geus-clan/TFRAS/README.md

# TFRAS
PCB prototype for sensor board used with resistive automatic ablation sensor.
