geus-clan/TFRAS/TFRAS/TFRAS_BOM.csv

Id | Designator | Package | Quantity | Designation | Supplier and ref
1 | J1,J2 | Molex_SlimStack_54722-0804_2x40_P0.50mm_Vertical | 2 |  | https://www.molex.com/molex/products/part-detail/pcb_receptacles/0547220804
