geus-clan/TFRAS/Software/TFRAS_calibrated_2.txt

/*
 * to do:
 * 
 * boards all return raw ADC
 * top boards compares against calibration table
 * this way the whole string can be calibrated once
 * 
 */

#define ADDRESS 99

/*
 * 97   a
 * 98   b
 * 99   c
 * 100  d
 * 101 e
 * 102 f
 * 
 */

#define UART_TX 44
#define UART_RX 45
#define TX_EN 2

#define S0 33
#define S1 32
#define S2 31

#define S0_ 16
#define S1_ 15
#define S2_ 14

//analog returns from mux
#define A_TOP 36
#define A_BOTTOM 25

#define ADC_THERM 29

#define nominal_resistance 10000       //Nominal resistance at 25⁰C
#define nominal_temeprature 25   // temperature for nominal resistance (almost always 25⁰ C)
#define samplingrate 5    // Number of samples 
#define beta 3950  // The beta coefficient or the B value of the thermistor (usually 3000-4000) check the datasheet for the accurate value.
#define Rref 10000   //Value of  resistor used for the voltage divider
int samples = 0;   //array to store the samples

//digital power pins
//top:
#define A 3
#define C 39
#define E 38
#define G 37
#define I 4
#define K 5
#define M 6

//bottom:
#define B_ 17
#define D_ 12
#define F_ 11
#define H_ 26
#define J_ 27
#define L_ 28

//analog pin addresses:
//top:
#define B 0
#define H 1
#define J 2
#define D 3
#define L 4
#define F 5

//bottom:
#define I_ 0
#define K_ 1
#define M_ 2
#define A_ 3
#define C_ 4
#define G_ 5
#define E_ 7

int topFlex[12];     //arrays for storing the cm of readings. e.g. topFlex[6] is between 6 and 7cm
int bottomFlex[12];

int topFlat[12] = {434,443,462,432,429,464,433,456,389,501,546,157};    //arrays for calibration at flat orientation
int bottomFlat[12] = {679,359,507,230,619,444,439,381,470,440,406,283};

int bottomBent[12]; //arrays for storing how bent the positions are in relation to flat orientation
int topBent[12];

/*
                    
A:
int topFlat[12] = {}; //calibration points --- what the standard ADC measurements are when they're flat. this should be optimized a lot later. temporary.
int bottomFlat[12] = {463, 466, 335, 333, 523, 413, 468, 470, 399, 341, 530, 251,};

B:int topFlat[12] = {434,443,462,432,429,464,433,456,389,501,546,157};    //arrays for calibration at flat orientation
int bottomFlat[12] = {679,359,507,230,619,444,439,381,470,440,406,283};
C:
int topFlat[12] = {299,500,414,433,456,374,432,362,326,458,312,259};    //arrays for calibration at flat orientation
int bottomFlat[12] = {664,407,444,418,436,462,392,375,415,416,409,358};
D:
int topFlat[12] = {403, 472, 440, 441, 362, 475, 366, 519, 446, 457, 501, 195};
int bottomFlat[12] = {594, 331, 496, 513, 308, 425, 401, 357, 404, 369, 427, 362};
                  
*/

void setCalibration(int adr){
  switch(adr){
    case 97: //'a'
     int a[24] = {0,0,0,0,0,0,0,0,0,0,0,0,578,378,450,342,529,444,453,507,377,384,498,260};
     for (int i=0;i<12;i++){
      topFlat[i] = a[i];
     }
     for (int i=12;i<24;i++){
      bottomFlat[i] = a[i];
     }

    break;
    case 98: //'b'
     int b[24] = {5,-37,-44,8,1,-20,-23,0,-32,16,-4,-9,76,-10,-50,-43,-30,-74,31,55,-17,-19,62,92};
     for (int i=0;i<12;i++){
      topFlat[i] = b[i];
     }
     for (int i=12;i<24;i++){
      bottomFlat[i] = b[i];
     }
    
    break;
    case 99: //'c'
     int c[24] = {299,500,414,433,456,374,432,362,326,458,312,259,664,407,444,418,436,462,392,375,415,416,409,358};
     for (int i=0;i<12;i++){
      topFlat[i] = c[i];
     }
     for (int i=12;i<24;i++){
      bottomFlat[i] = c[i];
     }
    break;
    
    case 100: //'d'
     int d[24] = {299,500,414,433,456,374,432,362,326,458,312,259,664,407,444,418,436,462,392,375,415,416,409,358};
     for (int i=0;i<12;i++){
      topFlat[i] = d[i];
     }
     for (int i=12;i<24;i++){
      bottomFlat[i] = d[i];
     }
    break;
  
  }
}

void setup() {

  //setCalibration(99);

Serial.begin(9600);

    pinMode(A_TOP, INPUT);
    pinMode(A_BOTTOM, INPUT);
    pinMode(ADC_THERM, INPUT);

    pinMode(A, OUTPUT);
    pinMode(C, OUTPUT);
    pinMode(E, OUTPUT);
    pinMode(G, OUTPUT);
    pinMode(I, OUTPUT);
    pinMode(K, OUTPUT); 
    pinMode(M, OUTPUT); 

    pinMode(B_, OUTPUT);
    pinMode(D_, OUTPUT);
    pinMode(F_, OUTPUT);
    pinMode(H_, OUTPUT);
    pinMode(J_, OUTPUT);
    pinMode(L_, OUTPUT); 

  pinMode(TX_EN, OUTPUT);

  pinMode(S0, OUTPUT);
  pinMode(S1, OUTPUT);
  pinMode(S2, OUTPUT);

  pinMode(S0_, OUTPUT);
  pinMode(S1_, OUTPUT);
  pinMode(S2_, OUTPUT);
  
  //digitalWrite(TX_EN, HIGH); //just temporary for testing: allow serial transmission any time
  
   digitalWrite(TX_EN, LOW); 

}

void readFlex(){
  /////Top section
  digitalWrite(A,HIGH);
  topFlex[11] = flexT(B) / 2.0; //TEMPORARY WORKAROUND
  digitalWrite(A,LOW);

  digitalWrite(C,HIGH);
  topFlex[10] = flexT(B);
  topFlex[9] = flexT(D);
  digitalWrite(C,LOW);

  digitalWrite(E,HIGH);
  topFlex[8] = flexT(D);
  topFlex[7] = flexT(F);
  digitalWrite(E,LOW);

  digitalWrite(G,HIGH);
  topFlex[6] = flexT(F);
  topFlex[5] = flexT(H);
  digitalWrite(G,LOW);
  
  digitalWrite(I,HIGH);
  topFlex[4] = flexT(H);
  topFlex[3] = flexT(J);
  digitalWrite(I,LOW);

  digitalWrite(K,HIGH);
  topFlex[2] = flexT(J);
  topFlex[1] = flexT(L);
  digitalWrite(K,LOW);

  digitalWrite(M,HIGH);
  topFlex[0] = flexT(L);
  digitalWrite(M,LOW);

  /////Bottom section
  digitalWrite(B_,HIGH);
  bottomFlex[0] = flexB(A_);
  bottomFlex[1] = flexB(C_);
  digitalWrite(B_,LOW);

  digitalWrite(D_,HIGH);
  bottomFlex[2] = flexB(C_);
  bottomFlex[3] = flexB(E_);
  digitalWrite(D_,LOW);

  digitalWrite(F_,HIGH);
  bottomFlex[4] = flexB(E_);
  bottomFlex[5] = flexB(G_);
  digitalWrite(F_,LOW);

  digitalWrite(H_,HIGH);
  bottomFlex[6] = flexB(G_);
  bottomFlex[7] = flexB(I_);
  digitalWrite(H_,LOW);
  
  digitalWrite(J_,HIGH);
  bottomFlex[8] = flexB(I_);
  bottomFlex[9] = flexB(K_);
  digitalWrite(J_,LOW);

  digitalWrite(L_,HIGH);
  bottomFlex[10] = flexB(K_);
  bottomFlex[11] = flexB(M_) / 2.0; //TEMPORARY WORKAROUND - last measurement 
  digitalWrite(L_,LOW);

}

int flexB(int a){
  addressMux(a);
  return analogRead(A_BOTTOM);
}

int flexT(int a){
  addressMux(a);
  return analogRead(A_TOP);
}

void addressMux(int a){
  switch(a){
    case 0:
    digitalWrite(S0,LOW);
    digitalWrite(S1,LOW);
    digitalWrite(S2,LOW);

    digitalWrite(S0_,LOW);
    digitalWrite(S1_,LOW);
    digitalWrite(S2_,LOW);
    break;
        
    case 1:
    digitalWrite(S0,HIGH);
    digitalWrite(S1,LOW);
    digitalWrite(S2,LOW);

    digitalWrite(S0_,HIGH);
    digitalWrite(S1_,LOW);
    digitalWrite(S2_,LOW);
    break;
        case 2:
    digitalWrite(S0,LOW);
    digitalWrite(S1,HIGH);
    digitalWrite(S2,LOW);

    digitalWrite(S0_,LOW);
    digitalWrite(S1_,HIGH);
    digitalWrite(S2_,LOW);
    break;
    
    case 3:
    digitalWrite(S0,HIGH);
    digitalWrite(S1,HIGH);
    digitalWrite(S2,LOW);

    digitalWrite(S0_,HIGH);
    digitalWrite(S1_,HIGH);
    digitalWrite(S2_,LOW);
    break;
        
    case 4:
    digitalWrite(S0,LOW);
    digitalWrite(S1,LOW);
    digitalWrite(S2,HIGH);

    digitalWrite(S0_,LOW);
    digitalWrite(S1_,LOW);
    digitalWrite(S2_,HIGH);
    break;
    
        case 5:        
    digitalWrite(S0,HIGH);
    digitalWrite(S1,LOW);
    digitalWrite(S2,HIGH);

    digitalWrite(S0_,HIGH);
    digitalWrite(S1_,LOW);
    digitalWrite(S2_,HIGH);
    break;
            case 7:
    digitalWrite(S0,HIGH);
    digitalWrite(S1,HIGH);
    digitalWrite(S2,HIGH);

    digitalWrite(S0_,HIGH);
    digitalWrite(S1_,HIGH);
    digitalWrite(S2_,HIGH);
    break;
  }
}

void printResults(){
    
 for(int i=0;i<12;i++){
    Serial.print(topFlex[i]);
    Serial.print(", ");
  }
  
 for(int i=0;i<12;i++){
    Serial.print(bottomFlex[i]);
    Serial.print(", ");
  }
    
  Serial.println();

}

int checkBend(int i){
  int x; //local result
  
    if(i < 200){
      x = 1;  //register binary bend in one direction
    }
    else if(i < 300){
      x = 2;  //register binary bend in one direction
    }
    else if(i > 500){
      x = 4;  //other direction
    }
    else if(i > 600){
      x = 5;  //other direction
    }
    else {
      x=3;  //no bend
    
 }
 return x;
    
}

int compareFlat(int i){
  int x; //local result
  /*
    if(topFlat[i] < topFlex){
      x = 1;  //register binary bend in one direction
    }
    else if(i < 300){
      x = 2;  //register binary bend in one direction
 }
 */
 x = topFlat[i] - topFlex[i];
 return x;
    
}

void loop() {

if (Serial.available() > 0){

 while (Serial.available() > 0)
 {
    int c = Serial.read();
    
    if (c == ADDRESS){
    
     readFlex();

      digitalWrite(TX_EN, HIGH);
      delay(15);
        Serial.print("<,");
    for(int i=0;i<12;i++){
      //Serial.print(topFlat[i] - topFlex[i]);
      Serial.print(topFlex[i]);

      Serial.print(",");
    }

    for(int i=0;i<12;i++){
      //Serial.print(bottomFlat[i] - bottomFlex[i]);
      
      Serial.print(bottomFlex[i]);

      Serial.print(",");
    }
    
     Serial.print((int)readTemp());
     Serial.println('>');
     Serial.flush();  //wait for all data to be sent before disabling coms
     digitalWrite(TX_EN, LOW);//rx enable, tx disable

   }

 }
  
}

}

float readTemp(void) {
  uint8_t i;
  float average;
  samples = 0;
  
  // take voltage readings from the voltage divider
  for (i = 0; i < samplingrate; i++) {
    samples += analogRead(ADC_THERM);
    delay(10);
  }
  average = 0;
  average = samples / samplingrate;

  // Calculate NTC resistance
  average = 1023 / average - 1;
  average = Rref / average;

  float temperature;
  temperature = average / nominal_resistance;     // (R/Ro)
  temperature = log(temperature);                  // ln(R/Ro)
  temperature /= beta;                   // 1/B * ln(R/Ro)
  temperature += 1.0 / (nominal_temeprature + 273.15); // + (1/To)
  temperature = 1.0 / temperature;                 // Invert
  temperature -= 273.15;                         // convert absolute temp to C

  return temperature*100.0; //must divide by 100 to get correct value. using ints because all bend data is int

}
