geus-clan/TFRAS/Schematics and PCBs/TFRAS_TOP/Gerbers, TFRAS_TOP/Testing plan.pdf

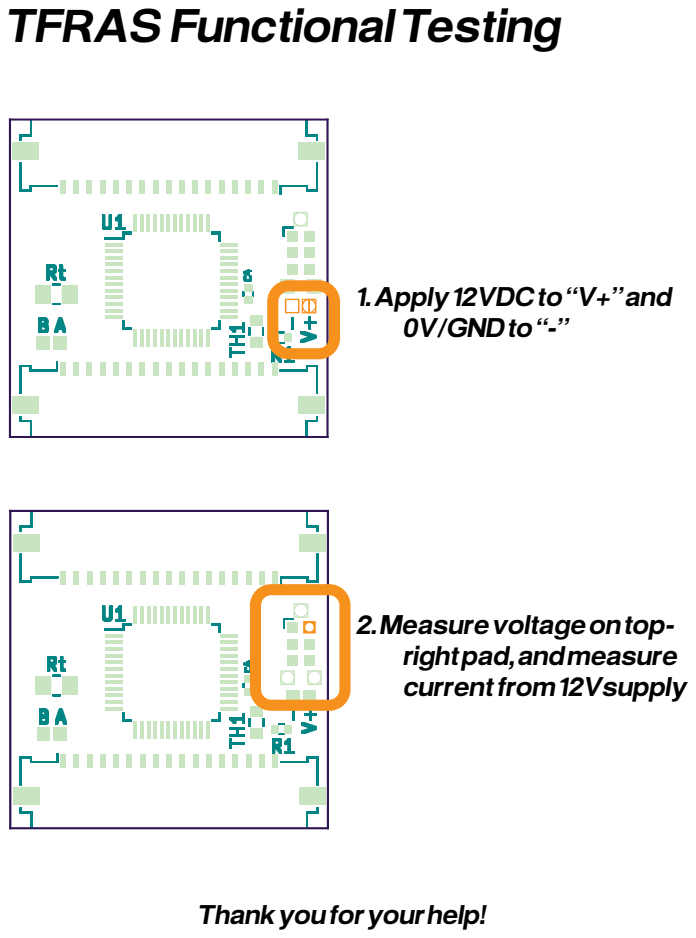
[picture p1: page 1]

2. Measure voltage on top-
right pad, and measure
current from 12Vsupply

Thank you for your help!
