geus-clan/TFRAS/Schematics and PCBs/PDFs/PCB_back.pdf

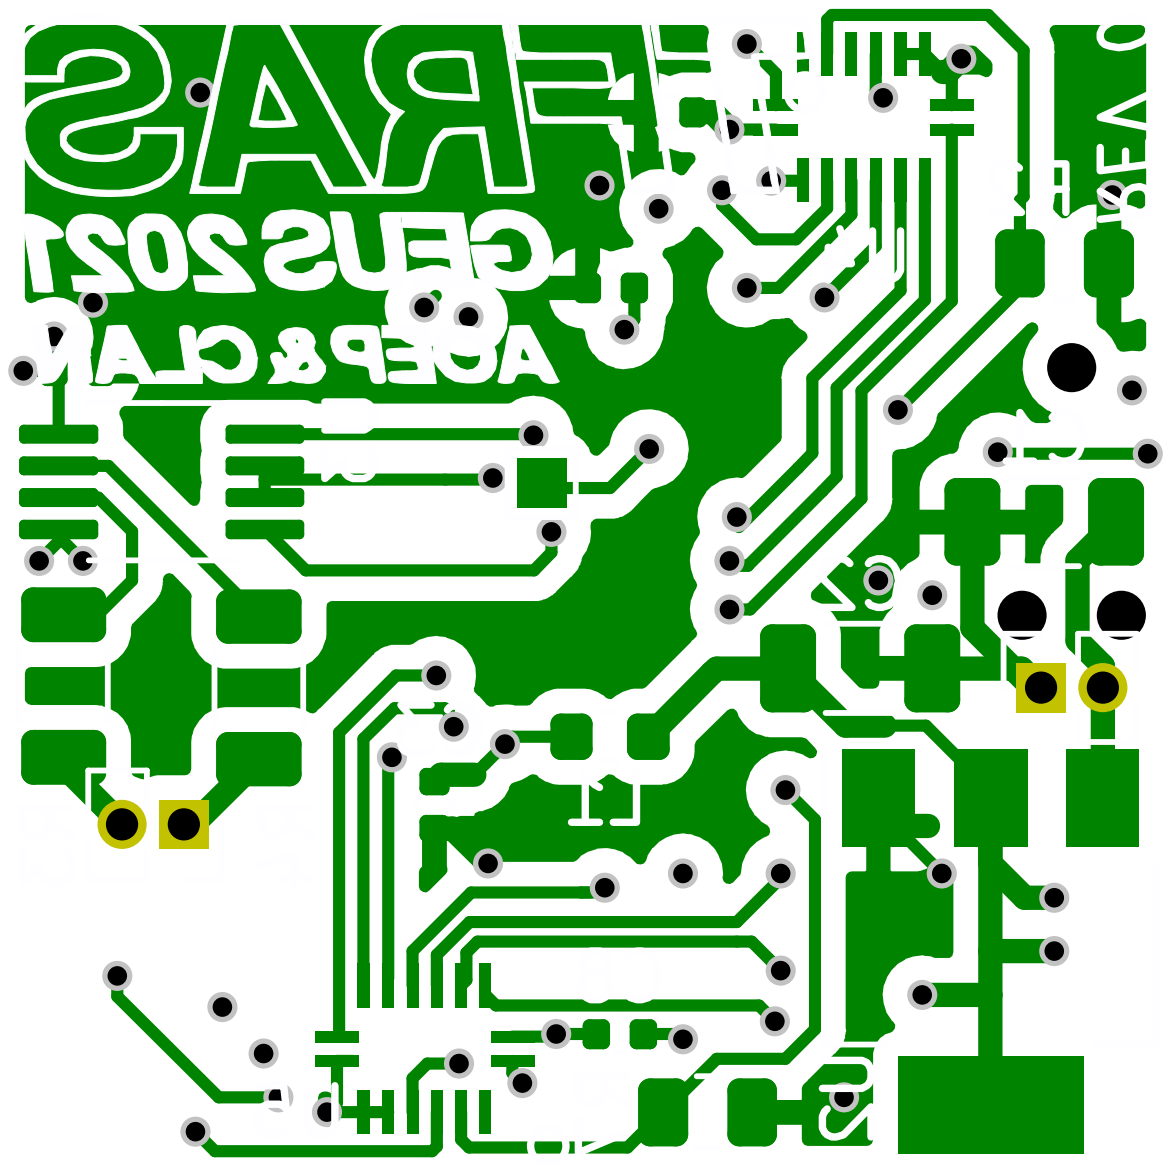
[picture p2: page 1]
