geus-clan/TFRAS/Schematics and PCBs/PDFs/PCB_front.pdf

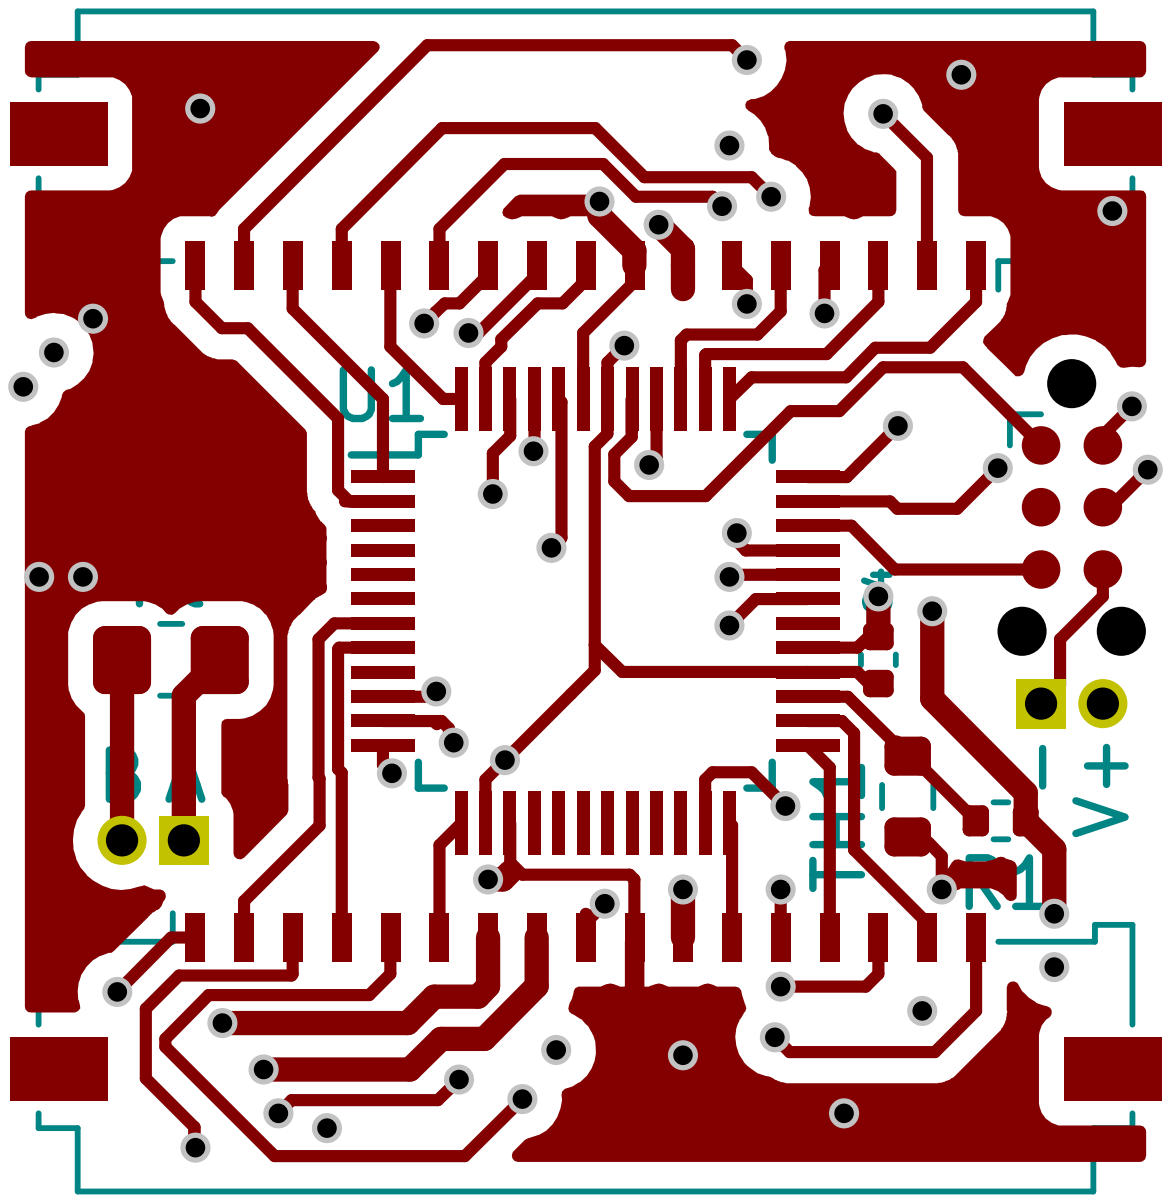
[picture p3: page 1]
