geus-clan/TFRAS/Schematics and PCBs/TFRAS_TOP/Gerbers, TFRAS_TOP/TFRAS_TOP-B_Cu.pdf

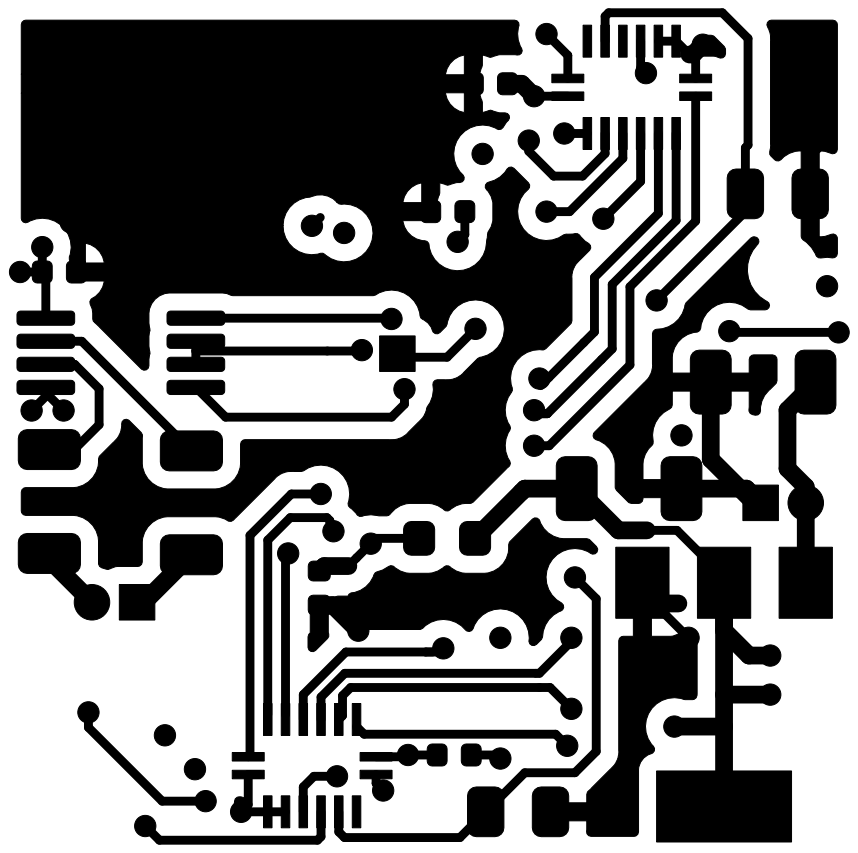
[picture p4: page 1]
