geus-clan/TFRAS/Schematics and PCBs/TFRAS_TOP/Gerbers, TFRAS_TOP/TFRAS_TOP-B_Silkscreen.pdf

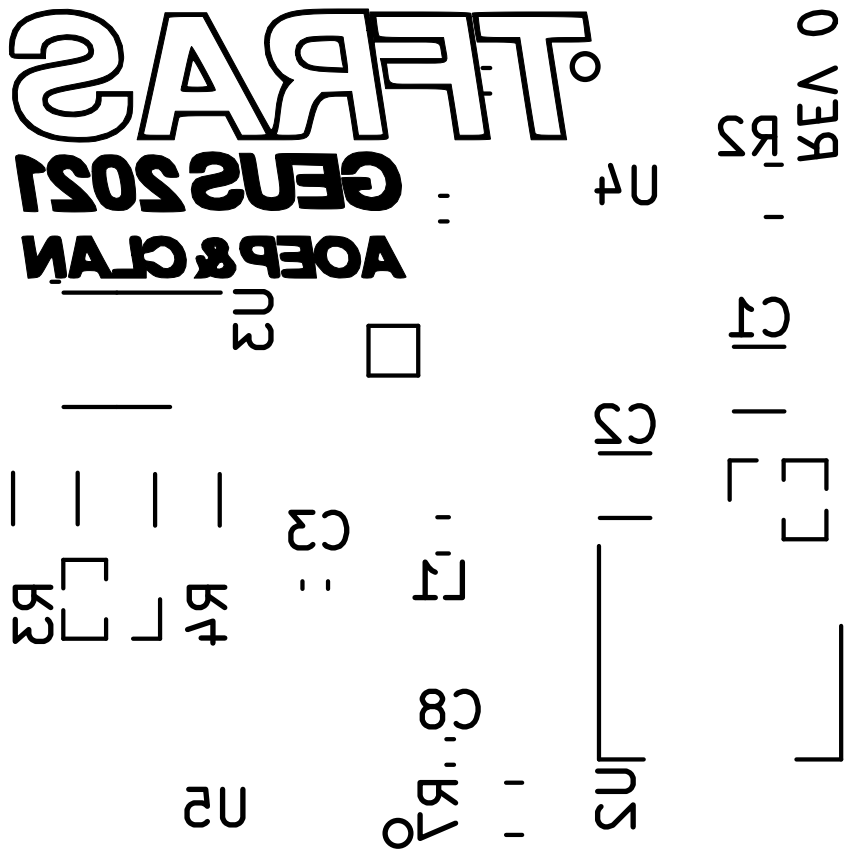
[picture p5: page 1]
