geus-clan/TFRAS/Schematics and PCBs/TFRAS_TOP/Gerbers, TFRAS_TOP/Back, PDF.pdf

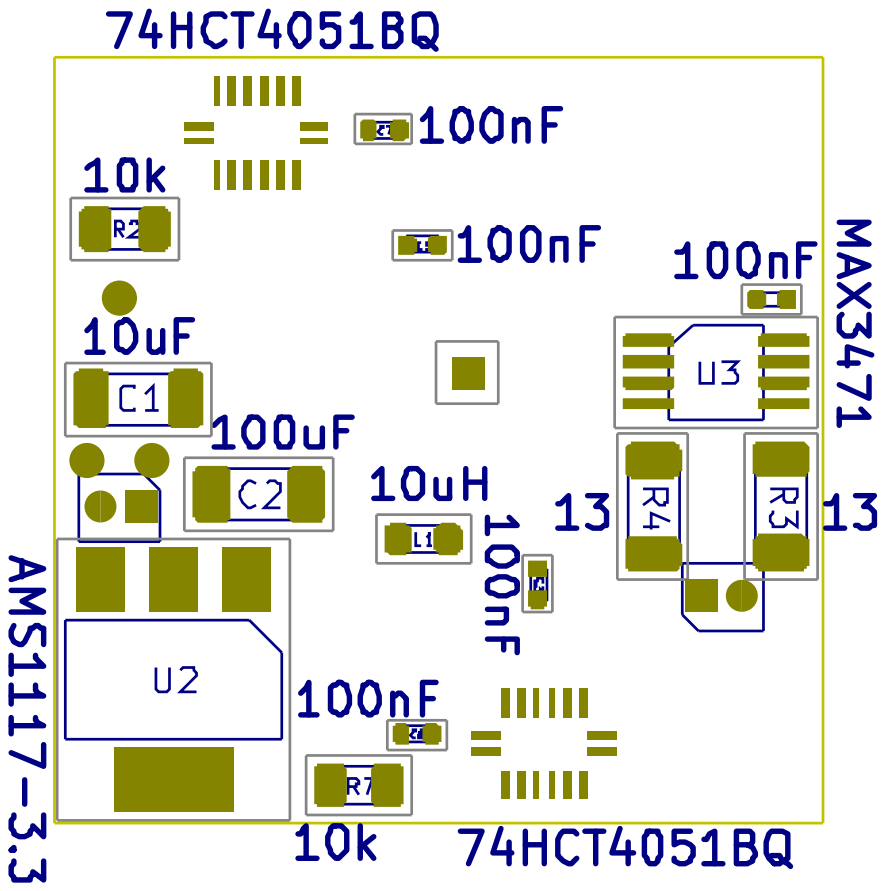
[picture p6: page 1]
