geus-clan/TFRAS/Schematics and PCBs/TFRAS_TOP/Gerbers, TFRAS_TOP/Front, PDF.pdf

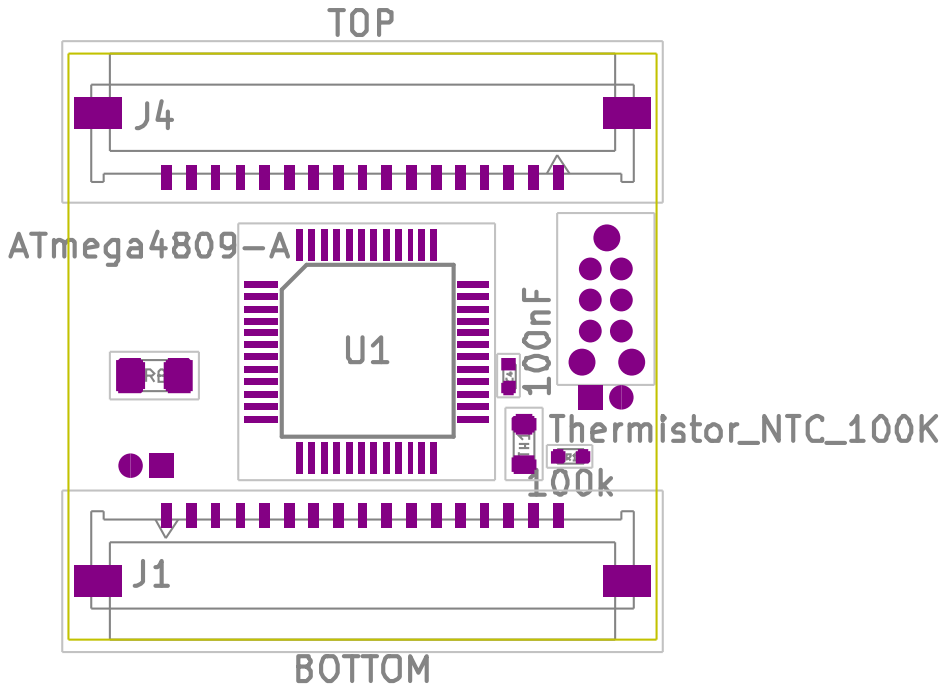
[picture p7: page 1]
