geus-clan/TFRAS/Schematics and PCBs/TFRAS_TOP/TFRAS_TOP.kicad_pcb

## KiCad design Schematics and PCBs/TFRAS_TOP/TFRAS_TOP.kicad_pcb (2022-08-12)

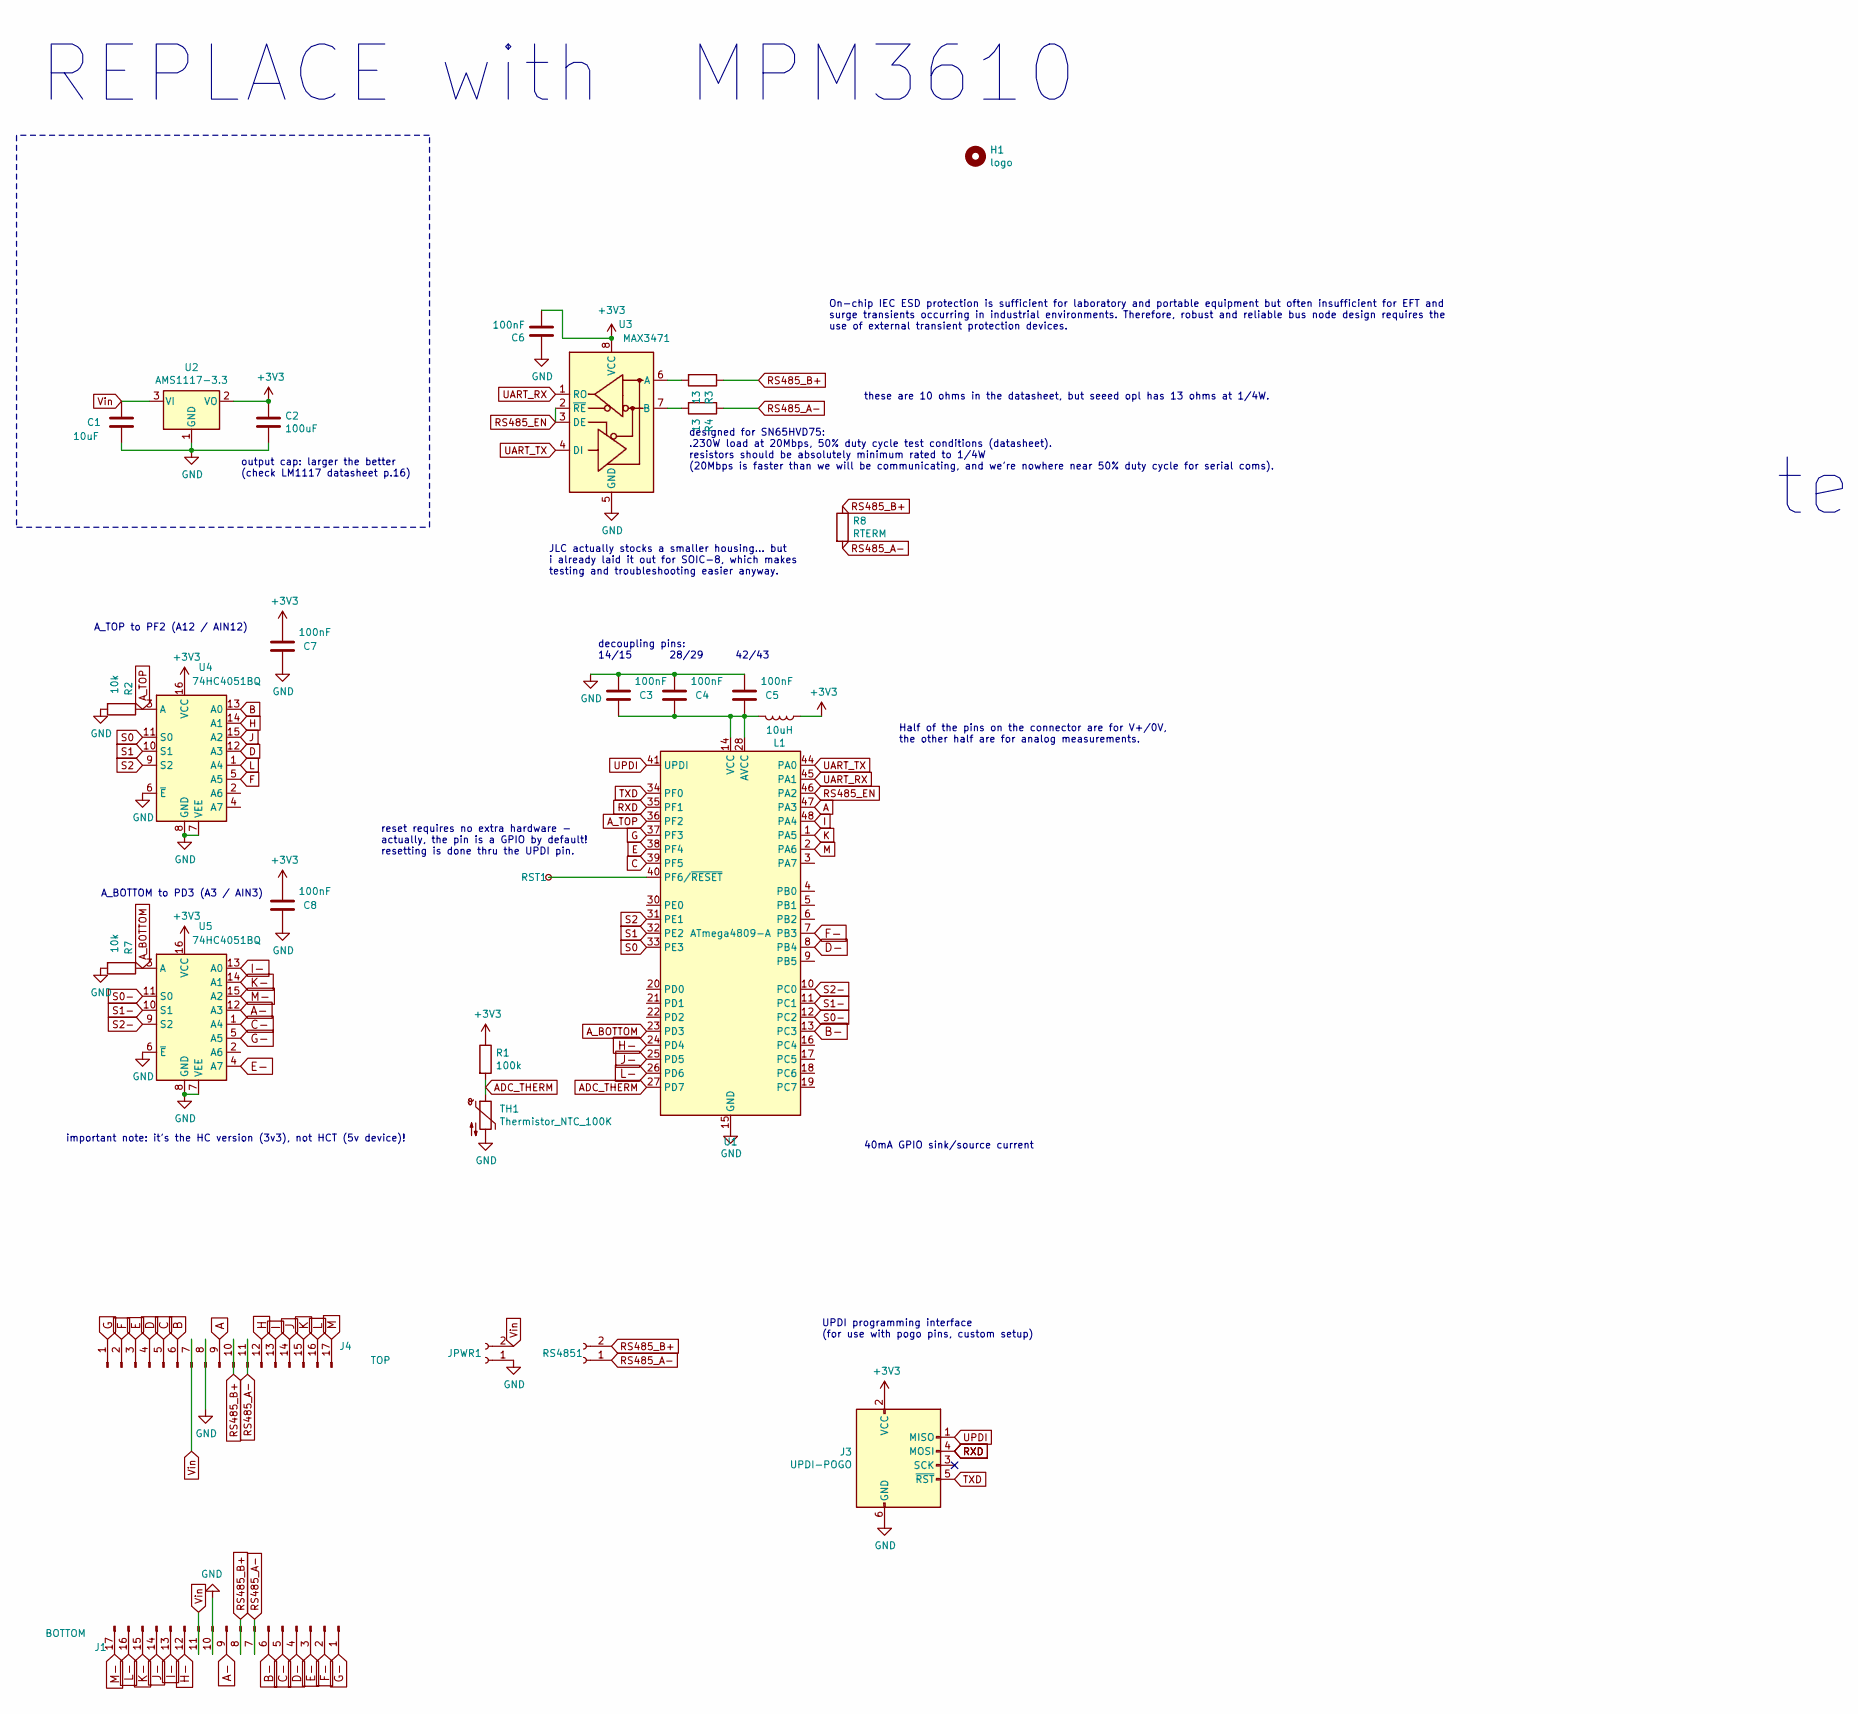
[picture p8: schematic TFRAS_TOP.sch, part in row 1, column 1]

Parts:
C1: 10uF; C_1206_3216Metric
C2: 100uF; C_1206_3216Metric
C3, C4, C5, C6, C7, C8: 100nF; C_0402_1005Metric; JLC part number C1525
H1: logo; TFRAS
J1: BOTTOM; Molex_200528-0170_1x17-1MP_P1.00mm_Horizontal
J3: UPDI-POGO; Tag-Connect_TC2030-IDC-NL_2x03_P1.27mm_Vertical; JLC part number ---
J4: TOP; Molex_200528-0170_1x17-1MP_P1.00mm_Horizontal; Mouser part number 538-200528-0170
JPWR1: Conn_01x02_Female; PinHeader_1x02_P1.27mm_Vertical; JLC part number ---
L1: 10uH; L_0603_1608Metric; JLC part number C1035
R1: 100k; R_0402_1005Metric
R2, R7: 10k; R_0805_2012Metric
R3, R4: 13; R_1206_3216Metric; JLC part number C17903
R8: RTERM; R_0805_2012Metric_Pad1.20x1.40mm_HandSolder; JLC part number ---
RS4851: Conn_01x02_Female; PinHeader_1x02_P1.27mm_Vertical; JLC part number ---
RST1: TestPoint_Small; TestPoint_Pad_1.0x1.0mm; JLC part number ---
TH1: Thermistor_NTC_100K; R_0603_1608Metric
U1: ATmega4809-A; TQFP-48_7x7mm_P0.5mm; JLC part number C189475
U2: AMS1117-3.3; SOT-223-3_TabPin2; JLC part number C6186
U3: MAX3471; MSOP-8_3x3mm_P0.65mm
U4, U5: 74HC4051BQ; SOT763-1(DHVQFN16); JLC part number C547696

Connections:
+3V3: C2.1, C6.2, C7.2, C8.2, J3.2 (VCC), L1.1, R1.1, U2.2 (VO), U3.8 (VCC), U4.16 (VCC), U5.16 (VCC)
A: J4.9, U1.47 (PA3)
A-: J1.9, U5.12 (A3)
ADC_THERM: R1.2, TH1.1, U1.27 (PD7)
A_BOTTOM: R7.1, U1.23 (PD3), U5.3 (A)
A_TOP: R2.1, U1.36 (PF2), U4.3 (A)
B: J4.6, U4.13 (A0)
B-: J1.6, U1.13 (PC3)
C: J4.5, U1.39 (PF5)
C-: J1.5, U5.1 (A4)
D: J4.4, U4.12 (A3)
D-: J1.4, U1.8 (PB4)
E: J4.3, U1.38 (PF4)
E-: J1.3, U5.4 (A7)
F: J4.2, U4.5 (A5)
F-: J1.2, U1.7 (PB3)
G: J4.1, U1.37 (PF3)
G-: J1.1, U5.5 (A5)
GND: C1.2, C2.2, C3.2, C4.2, C5.2, C6.1, C7.1, C8.1, J1.10, J3.6 (GND), J4.8, JPWR1.1, R2.2, R7.2, TH1.2, U1.15 (GND), U1.29 (GND), U1.43 (GND), U2.1 (GND), U3.5 (GND), U4.6 (~E), U4.7 (VEE), U4.8 (GND), U5.6 (~E), U5.7 (VEE), U5.8 (GND)
H: J4.12, U4.14 (A1)
H-: J1.12, U1.24 (PD4)
I: J4.13, U1.48 (PA4)
I-: J1.13, U5.13 (A0)
J: J4.14, U4.15 (A2)
J-: J1.14, U1.25 (PD5)
K: J4.15, U1.1 (PA5)
K-: J1.15, U5.14 (A1)
L: J4.16, U4.1 (A4)
L-: J1.16, U1.26 (PD6)
M: J4.17, U1.2 (PA6)
M-: J1.17, U5.15 (A2)
unnamed: C3.1, C4.1, C5.1, L1.2, U1.14 (VCC), U1.28 (AVCC), U1.42 (VCC)
unnamed: R3.2, U3.6 (A)
unnamed: R4.2, U3.7 (B)
unnamed: RST1.1, U1.40 (PF6/~RESET)
RS485_A-: J1.7, J4.11, R4.1, R8.2, RS4851.1
RS485_B+: J1.8, J4.10, R3.1, R8.1, RS4851.2
RS485_EN: U1.46 (PA2), U3.2 (~RE), U3.3 (DE)
RXD: J3.4 (MOSI), U1.35 (PF1)
S0: U1.33 (PE3), U4.11 (S0)
S0-: U1.12 (PC2), U5.11 (S0)
S1: U1.32 (PE2), U4.10 (S1)
S1-: U1.11 (PC1), U5.10 (S1)
S2: U1.31 (PE1), U4.9 (S2)
S2-: U1.10 (PC0), U5.9 (S2)
TXD: J3.5 (~RST), U1.34 (PF0)
UART_RX: U1.45 (PA1), U3.1 (RO)
UART_TX: U1.44 (PA0), U3.4 (DI)
UPDI: J3.1 (MISO), U1.41 (UPDI)
Vin: C1.1, J1.11, J4.7, JPWR1.2, U2.3 (VI)

Notes on the sheet:
test RS485 section
test points from serial port (uart)
40mA GPIO sink/source current
decoupling pins: 14/15 28/29 42/43
UPDI programming interface (for use with pogo pins, custom setup)
A_TOP to PF2 (A12 / AIN12)
A_BOTTOM to PD3 (A3 / AIN3)
Half of the pins on the connector are for V+/0V, the other half are for analog measurements.
On-chip IEC ESD protection is sufficient for laboratory and portable equipment but often insufficient for EFT and surge transients occurring in industrial environments. Therefore, robust and reliable bus node design requires the use of external transient protection devices.
output cap: larger the better (check LM1117 datasheet p.16)
designed for SN65HVD75: .230W load at 20Mbps, 50% duty cycle test conditions (datasheet). resistors should be absolutely minimum rated to 1/4W (20Mbps is faster than we will be communicating, and we’re nowhere near 50% duty cycle for serial coms).
JLC actually stocks a smaller housing… but i already laid it out for SOIC-8, which makes testing and troubleshooting easier anyway.
these are 10 ohms in the datasheet, but seeed opl has 13 ohms at 1/4W.
reset requires no extra hardware - actually, the pin is a GPIO by default! resetting is done thru the UPDI pin.
important note: it’s the HC version (3v3), not HCT (5v device)!
REPLACE with MPM3610

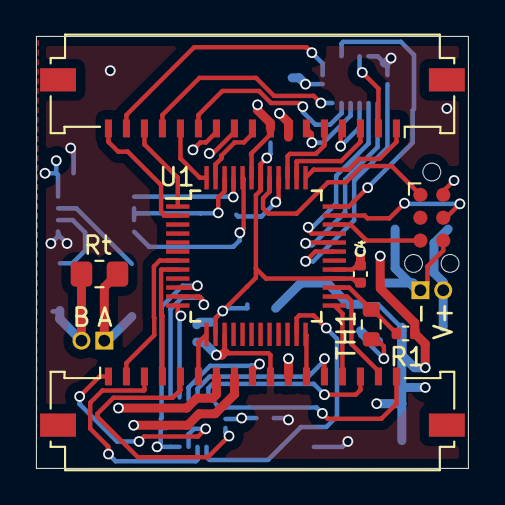
[picture p9: board Schematics and PCBs/TFRAS_TOP/TFRAS_TOP.kicad_pcb from above]

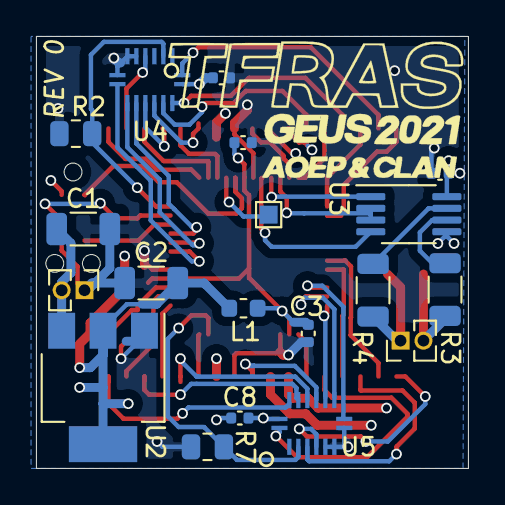
[picture p10: board Schematics and PCBs/TFRAS_TOP/TFRAS_TOP.kicad_pcb from below]

Board: 4 copper layers, 24.0 x 24.0 mm, 28 parts (20 on the bottom side), 50 nets.
