geus-clan/TFRAS/Schematics and PCBs/Legacy/TFRAS_TOP_legacy/TFRAS_TOP.kicad_pcb

## KiCad design Schematics and PCBs/Legacy/TFRAS_TOP_legacy/TFRAS_TOP.kicad_pcb (2021-08-30, an earlier design)

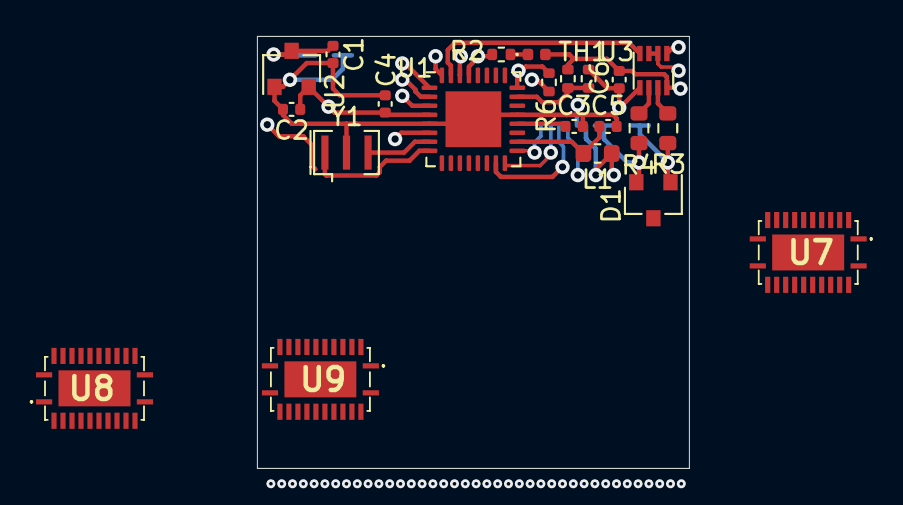
[picture p11: board Schematics and PCBs/Legacy/TFRAS_TOP_legacy/TFRAS_TOP.kicad_pcb from above]

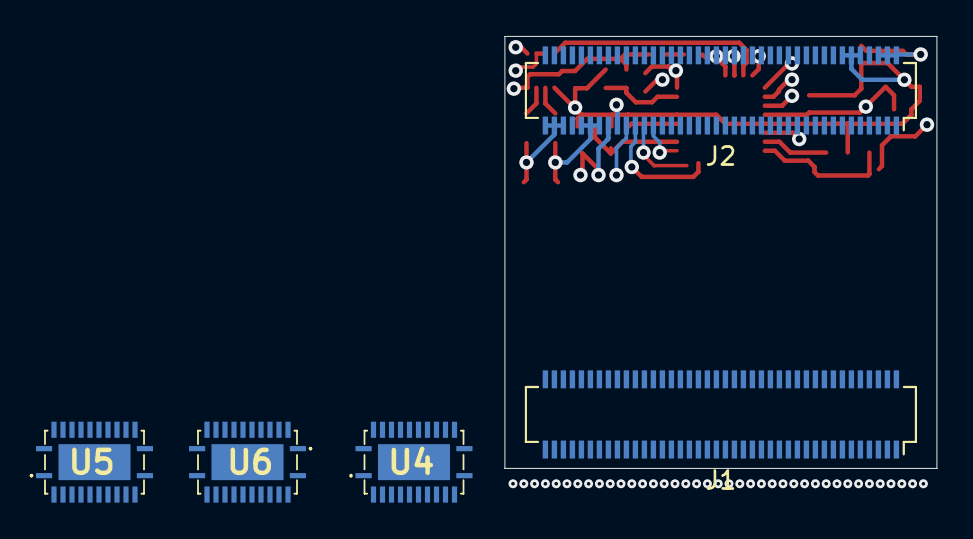
[picture p12: board Schematics and PCBs/Legacy/TFRAS_TOP_legacy/TFRAS_TOP.kicad_pcb from below]

Board: 4 copper layers, 24.0 x 24.0 mm, 27 parts (5 on the bottom side), 80 nets.

Parts:
C1: 1uF/16V; C_0402_1005Metric
C2: 1uF/6.3V; C_0402_1005Metric
C3, C4, C5, C6: 100nF; C_0402_1005Metric
D1: CDSOT23-SM712; SOT-23
D2: 1N4148; D_0402_1005Metric
J1, J2: Molex 555600807; Molex_SlimStack_55560-0801_2x40_P0.50mm_Vertical
L1: 10uH; L_0603_1608Metric
R1, R2, R6: 10K; R_0402_1005Metric
R3, R4: 10; R_0603_1608Metric
TH1: Thermistor_NTC_10K; R_0402_1005Metric
U1: ATmega328PB-MU; QFN-32-1EP_5x5mm_P0.5mm_EP3.1x3.1mm
U2: MCP1754S-3302xCB; SOT-23
U3: MAX14783EATA+T; DFN-8_2x2mm_P0.5mm
U4, U5, U6, U7, U8, U9: 74HC4067BQ,118; 74LVCH8T245BQQ10J
Y1: Resonator; Resonator_SMD_muRata_CSTxExxV-3Pin_3.0x1.1mm

Connections:
+3V3: C2.1, C4.1, C6.2, D2.2, J2.65, L1.1, R1.1, U1.4, U2.2, U3.8, U4.1, U4.24, U5.1, U5.24, U6.1, U6.24, U7.24, U8.24, U9.24
ADC: R1.2, TH1.1, U1.23
BS0: J1.39, J1.41
BS1: J1.37, U7.9
BS2: J1.28, U7.8
BS3: J1.35, U7.7
BS4: J1.33, U7.6
BS5: J1.24, U7.5
BS6: J1.29, U7.4
BS7: J1.20, U7.3
BS8: J1.19, U4.23, U7.2
BS9: J1.16, U4.2, U4.22, U7.23
BS10: J1.14, U4.3, U4.21, U7.22
BS11: J1.12, U4.4, U4.20, U7.21
BS12: J1.10, U4.5, U4.19, U7.20
BS13: J1.8, U4.6, U4.18, U7.19
BS14: J1.6, U4.7, U4.17, U7.18
BS15: J1.3, U4.16, U7.17
BS16: J1.4, U4.8, U5.9, U7.16
BS17: J1.1, U5.8, U8.9
BS18: J1.2, U4.9, U5.7, U8.8
BS19: J1.43, U5.6, U8.7
BS20: J1.54, U5.5, U8.6
BS21: J1.45, U5.4, U8.5
BS22: J1.47, U5.3, U8.4
BS23: J1.58, U5.2, U8.3
BS24: J1.51, U5.23, U8.2
BS25: J1.62, U5.22, U8.23
BS26: J1.61, U5.21, U8.22
BS27: J1.66, U5.20, U8.21
BS28: J1.68, U5.19, U8.20
BS29: J1.70, U5.18, U8.19
BS30: J1.72, U5.17, U8.18
BS31: J1.74, U5.16, U8.17
BS32: J1.76, U6.9, U8.16
BS33: J1.77, U6.8, U9.9
BS34: J1.78, U6.7, U9.8
BS35: J1.79, U6.6, U9.7
BS36: J1.80, U6.5, U9.6
BS37: J1.42, U6.4, U9.5
BS38: J1.40, U6.3, U9.4
BS39: J1.36, U6.2, U9.3
BS40: J1.32, U6.23, U9.2
BS41: J1.26, U6.22, U9.23
BS42: J1.22, U6.21, U9.22
BS43: J1.18, U6.20, U9.21
BS44: J1.46, U6.19, U9.20
BS45: J1.50, U6.18, U9.19
BS46: J1.56, U6.17, U9.18
BS47: J1.60, U6.16, U9.17
BS48: J1.64, U9.16
E1: U1.9, U4.15
E2: U1.10, U7.15
E3: U1.11, U5.15
E4: U1.12, U8.15
E5: U1.13, U6.15
E6: U1.14, U9.15
GND: C1.2, C2.2, C3.2, C4.2, C5.2, C6.1, D1.3, J1.13, J1.15, J1.17, J2.10, J2.12, J2.14, J2.63, R6.1, TH1.2, U1.5, U1.21, U1.33, U2.1, U3.5, U4.12, U5.12, U6.12, U7.12, U8.12, U9.12, Y1.2
MISO: J2.57, U1.16
MOSI: J2.59, U1.15
unnamed: C3.1, U1.20
unnamed: C5.1, L1.2, U1.18
unnamed: D2.1, R2.1
unnamed: R3.2, U3.7
unnamed: R4.2, U3.6
unnamed: U1.7, Y1.3
unnamed: U1.8, Y1.1
RS485_A-: D1.2, J1.71, J1.73, J1.75, J2.67, J2.69, J2.71, R4.1
RS485_B+: D1.1, J1.63, J1.65, J1.67, J2.75, J2.77, J2.79, R3.1
RS485_EN: U1.32, U3.2, U3.3
RST: J2.61, R2.2, U1.29
S0: U1.1, U4.10, U5.10, U6.10, U7.10, U8.10, U9.10
S1: U1.2, U4.11, U5.11, U6.11, U7.11, U8.11, U9.11
S2: U1.3, U4.14, U5.14, U6.14, U7.14, U8.14, U9.14
S3: U1.6, U4.13, U5.13, U6.13, U7.13, U8.13, U9.13
SCK: J2.55, U1.17
UART_RX: U1.30, U3.1
UART_TX: U1.31, U3.4
Vin: C1.1, J1.5, J1.7, J1.9, J2.2, J2.4, J2.6, U2.3
Z: R6.2, U1.24, U7.1, U8.1, U9.1
