geus-clan/TFRAS/(commit log)

2021-10-21 organization and updating project files
    [TFRAS-B_Cu.gbr, TFRAS-Eco1_User.gbr, TFRAS-Edge_Cuts.gbr, TFRAS-F_Cu.gbr, TFRAS-F_Mask.gbr, TFRAS-F_Paste.gbr, TFRAS-F_SilkS.gbr, TFRAS-In1_Cu.gbr]
2021-10-22 PCB finished with seeed BOM
    [TFRAS_TOP bom.csv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]
2021-10-26 added pdf schematic
    [TFRAS_TOP.kicad_pcb, TFRAS_TOP.sch]
2022-01-05 tfras pcb
    [TFRAS_TOP.sch]
2022-08-16 software updates
    [TFRAS_TOP.kicad_pcb]
2022-08-17 functional prototype software
